20060806asdwer-dot/m/hardware/Connections.csv

sheet | ref | pin | net
1 | U1 | PA0 | VSTORE_ADC
1 | U1 | PA1 | TEMP_DQ
1 | U1 | PB6 | I2C_SCL
1 | U1 | PB7 | I2C_SDA
1 | U1 | PA9 | RADIO_RX
1 | U1 | PA10 | RADIO_TX
1 | U1 | PB0 | RADIO_M0
1 | U1 | PB1 | RADIO_M1
1 | U1 | PB10 | RADIO_AUX
1 | U1 | 3V3 | 3V3_NODE
1 | U1 | GND | GND_NODE
1 | U1 | PA13 | SWDIO
1 | U1 | PA14 | SWCLK
1 | U1 | NRST | NRST
1 | U1 | PA2 | DBG_TX
1 | U1 | PA3 | DBG_RX
1 | C5 | 1 | 3V3_NODE
1 | C5 | 2 | GND_NODE
1 | C6 | 1 | 3V3_NODE
1 | C6 | 2 | GND_NODE
1 | J1 | SWDIO | SWDIO
1 | J1 | SWCLK | SWCLK
1 | J1 | GND | GND_NODE
1 | J1 | NRST | NRST
1 | J1 | VTref | 3V3_NODE
1 | J2 | RXD | DBG_TX
1 | J2 | TXD | DBG_RX
1 | J2 | GND | GND_NODE
2 | U2 | 3 | 3V3_NODE
2 | U2 | 2 | TEMP_DQ
2 | U2 | 1 | GND_NODE
2 | R1 | 1 | 3V3_NODE
2 | R1 | 2 | TEMP_DQ
2 | C1 | 1 | 3V3_NODE
2 | C1 | 2 | GND_NODE
2 | U3 | SCL | I2C_SCL
2 | U3 | SDA | I2C_SDA
2 | U3 | CS | 3V3_NODE
2 | U3 | SDO | GND_NODE
2 | U3 | VCC | 3V3_NODE
2 | U3 | GND | GND_NODE
2 | R2 | 1 | 3V3_NODE
2 | R2 | 2 | I2C_SCL
2 | R3 | 1 | 3V3_NODE
2 | R3 | 2 | I2C_SDA
2 | C2 | 1 | 3V3_NODE
2 | C2 | 2 | GND_NODE
2 | JP1 | 1 | VSTORE
2 | JP1 | 2 | VSTORE_DIV_IN
2 | R6 | 1 | VSTORE_DIV_IN
2 | R6 | 2 | VSTORE_ADC
2 | R7 | 1 | VSTORE_ADC
2 | R7 | 2 | GND_NODE
2 | C3 | 1 | VSTORE_ADC
2 | C3 | 2 | GND_NODE
3 | U4 | RXD | RADIO_RX
3 | U4 | TXD | RADIO_TX
3 | U4 | M0 | RADIO_M0
3 | U4 | M1 | RADIO_M1
3 | U4 | AUX | RADIO_AUX
3 | U4 | VCC | 3V3_NODE
3 | U4 | GND | GND_NODE
3 | R4 | 1 | 3V3_NODE
3 | R4 | 2 | RADIO_M0
3 | R5 | 1 | 3V3_NODE
3 | R5 | 2 | RADIO_M1
3 | C7 | 1 | 3V3_NODE
3 | C7 | 2 | GND_NODE
3 | C8 | 1 | 3V3_NODE
3 | C8 | 2 | GND_NODE
3 | U5 | VCC | 3V3_RX
3 | U5 | GND | GND_RX
3 | U5 | M0 | GND_RX
3 | U5 | M1 | GND_RX
3 | U5 | TXD | RX_TO_PC
3 | U5 | RXD | PC_TO_RX
3 | J5 | RXD | RX_TO_PC
3 | J5 | TXD | PC_TO_RX
3 | J5 | GND | GND_RX
3 | C9 | 1 | 3V3_RX
3 | C9 | 2 | GND_RX
3 | C10 | 1 | 3V3_RX
3 | C10 | 2 | GND_RX
3 | J4 | 1 | 3V3_RX
3 | J4 | 2 | GND_RX
4 | U6 | 1 | VSTORE
4 | U6 | 3 | VSTORE
4 | U6 | 5 | REG3V3
4 | U6 | 2 | GND_NODE
4 | C11 | 1 | VSTORE
4 | C11 | 2 | GND_NODE
4 | C12 | 1 | REG3V3
4 | C12 | 2 | GND_NODE
4 | J3 | 1 | VSTORE
4 | J3 | 2 | GND_NODE
4 | SW1 | 1 | EXT3V3
4 | SW1 | 2 | 3V3_NODE
4 | SW1 | 3 | REG3V3
4 | J6 | 1 | EXT3V3
4 | J6 | 2 | GND_NODE
