20060806asdwer-dot/m/hardware/Schematic_Preview.png

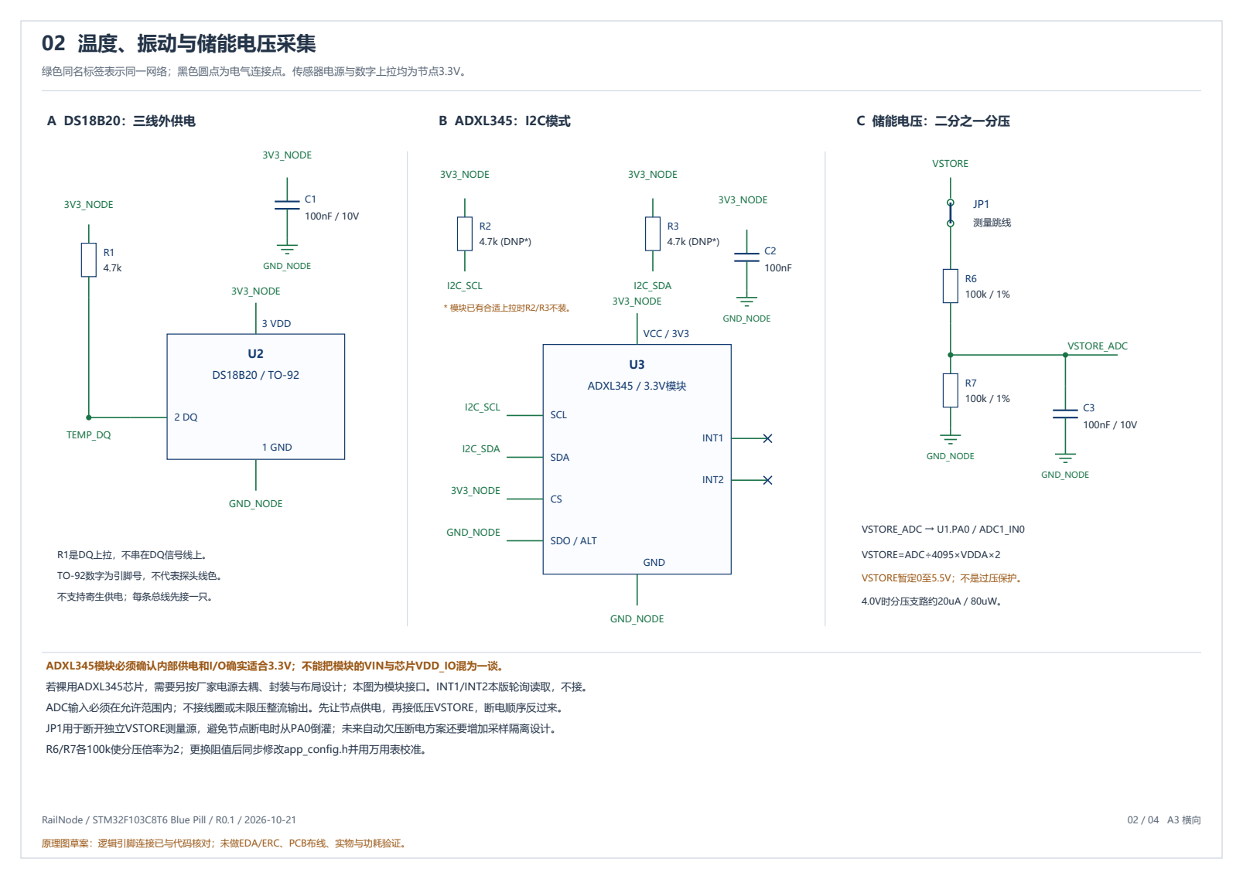
hardware/Schematic_Preview.png
