20060806asdwer-dot/m/hardware/BOM.csv

ref | value | sheet | note
U1 | STM32F103C8T6 Blue Pill | 1 | 按排针丝印接线，不作为裸芯片封装；BOOT0=0，PC13板载LED
C5 | 100nF / 10V | 1 | 非极性去耦/滤波
C6 | 10uF / 10V | 1 | 非极性去耦/滤波
J1 | SWD逻辑接口 | 1 | 调试器若标3.3V的是供电输出，则不并接到已供电目标
J2 | 3.3V逻辑 USB-TTL调试口 | 1 | VCC悬空，避免电脑向节点倒灌
U2 | DS18B20+ / TO-92 | 2 | 1=GND，2=DQ，3=VDD；其他封装/探头线色需核对
R1 | 4.7k | 2 | 电阻；按图连接
C1 | 100nF / 10V | 2 | 非极性去耦/滤波
U3 | ADXL345 3.3V兼容I2C模块 | 2 | CS高，SDO低，7位地址0x53；内部供电/I/O电压必须确认
R2 | 4.7k (DNP*) | 2 | 电阻；按图连接
R3 | 4.7k (DNP*) | 2 | 电阻；按图连接
C2 | 100nF | 2 | 非极性去耦/滤波
JP1 | 1x2 ADC测量跳线（调试时闭合） | 2 | 节点无电时断开外部VSTORE，避免PA0倒灌
R6 | 100k / 1% | 2 | 电阻；按图连接
R7 | 100k / 1% | 2 | 电阻；按图连接
C3 | 100nF / 10V | 2 | 非极性去耦/滤波
U4 | E22-400T22D + 匹配天线 | 3 | 节点端，M1/M0=00正常、11休眠；核对实际版本手册
R4 | 100k | 3 | 电阻；按图连接
R5 | 100k | 3 | 电阻；按图连接
C7 | 100nF / 10V | 3 | 非极性去耦/滤波
C8 | 220uF / 10V | 3 | 有极性，正极接高端
U5 | E22-400T22D + 匹配天线 | 3 | 接收端独立3.3V，模式脚接地，配置参数与U4匹配
J5 | 电脑接收USB-TTL | 3 | 真实串口--ack时必须接TXD
C9 | 100nF / 10V | 3 | 非极性去耦/滤波
C10 | 220uF / 10V | 3 | 有极性，正极接高端
J4 | 接收端独立3.3V电源口 | 3 | 外部电源覆盖射频峰值；TTL供电能力不可凭标签假定
U6 | LP5907MFX-3.3/NOPB / SOT-23-5 | 4 | 仅按DBV/MFX封装：1IN 2GND 3EN 4NC 5OUT，其他封装不可套用
C11 | 2.2uF / 10V | 4 | 非极性去耦/滤波
C12 | 2.2uF / 10V | 4 | 非极性去耦/滤波
J3 | 受控低压VSTORE输入口 | 4 | 初期限流直流验证；最终取电输出须经保护与储能管理
SW1 | SPDT先断后合电源选择开关 | 4 | 手动在外部3.3V与LDO输出之间选择，非自动电源路径
J6 | 节点外部3.3V电源口 | 4 | 独立电源覆盖MCU/传感器/无线峰值；不等于TTL供电脚
