20060806asdwer-dot/m/(list of files, drawings)

Other design files:
hardware/schematic_scene.json
