20060806asdwer-dot/m/firmware/Core/Src/energy_policy.c

/* 【06 能量状态：保护、低能量、正常】
 * 阅读导航：docs/代码阅读地图.md。
 */
#include "energy_policy.h"
#include "app_config.h"
energy_action_t energy_update(energy_state_t previous,uint16_t mv,bool valid,bool adaptive)
{
    /* A 默认保护：无效读数和异常状态均不允许发射 */
    energy_action_t a={ENERGY_PROTECT,PROTECT_POLL_S,false,false};
    if(!valid || mv<STORE_PROTECT_MV ||
       (previous!=ENERGY_PROTECT && previous!=ENERGY_LOW && previous!=ENERGY_NORMAL))return a;
    /* B 保护恢复：必须达到恢复阈值 */
    if(previous==ENERGY_PROTECT && mv<STORE_RECOVER_MV)return a;
    /* C 状态滞回：固定版保持正常周期，自适应版按电压分档 */
    if(!adaptive || mv>=STORE_NORMAL_ENTER_MV ||
       (previous==ENERGY_NORMAL && mv>=STORE_NORMAL_EXIT_MV)) {
        a.state=ENERGY_NORMAL;a.period_s=FIXED_PERIOD_S;a.allow_vibration=true;
    } else {a.state=ENERGY_LOW;a.period_s=LOW_PERIOD_S;}
    a.allow_radio=true;
    return a;
}
