20060806asdwer-dot/m/(commit log)

2026-10-21 Add STM32F103C8T6 RailNode firmware, desktop tools and build artifacts
    Provide five compiled profiles, staged wiring and VS Code instructions, sensor and E22 drivers, energy policy, CRC telemetry, offline 3D concept and DeepSeek review helper.
    Validated: all profiles build with STM32 GCC; pure ARM C logic and Python protocol/analysis checks pass. Physical hardware, RF, power harvesting and STOP wake remain untested.
    [结构草模.scad]
2026-10-21 Complete offline-testable firmware paths and add Chinese code navigation
    Add optional matched ACK with bounded retry and UART RX buffering, I2C recovery, capacitor energy budgeting and adaptive periods. Label application modules and main-loop steps in Chinese, with a file map and hardware acceptance checklist.
    Validation: six profiles compile with -Wall -Wextra -Werror; 4688 ARM core/fake-HAL checks and eight desktop/stream/fake-serial tests pass. Physical peripherals, RF timing, STOP wake and energy calibration remain unverified.
    [结构草模.scad]
2026-10-21 Add four-sheet module schematic draft, BOM and pin-net connection table
    Provide vector PDF/SVGs for Blue Pill interfaces, sensors and ADC, LoRa node/receiver, and verified LP5907 pinout/manual power selection. Include editable scene/generator and local schematic viewer.
    Status: draft module wiring only, 32 parts and 100 pin/net mappings checked. Harvesting protection, buck/charging, capacitor selection and hardware UVLO remain unresolved. No EDA/ERC, PCB/Gerber, circuit simulation or physical validation.
    [BOM.csv, Connections.csv, schematic_scene.json]
